Vitoko-Arriagada/Neutrino-2014/README.md

# Neutrino-2014
Neutrino. Robot Autónomo de velocidad

- [Informe][informe]

- [Presentación][presentacion]

Códigos de prueba y para competencia:
- [Neutrino V1.0][ver1]
- [Neutrino V2.0][ver2]
- [Neutrino V3.0][ver3]

  [ver1]: https://github.com/Vitoko-Arriagada/Neutrino-2014/tree/main/Neutrino%20version%201.0
  [ver2]: https://github.com/Vitoko-Arriagada/Neutrino-2014/tree/main/Neutrino%20version%202.0/Codigos
  [ver3]: https://github.com/Vitoko-Arriagada/Neutrino-2014/tree/main/Neutrino%20version%203.0
  [informe]: https://github.com/Vitoko-Arriagada/Neutrino-2014/blob/main/Informe%20Neutrino%202014.pdf
  [presentacion]: https://github.com/Vitoko-Arriagada/Neutrino-2014/blob/main/NEUTRINO.pptx
