Vitoko-Arriagada/Neutrino-2014/portada.png

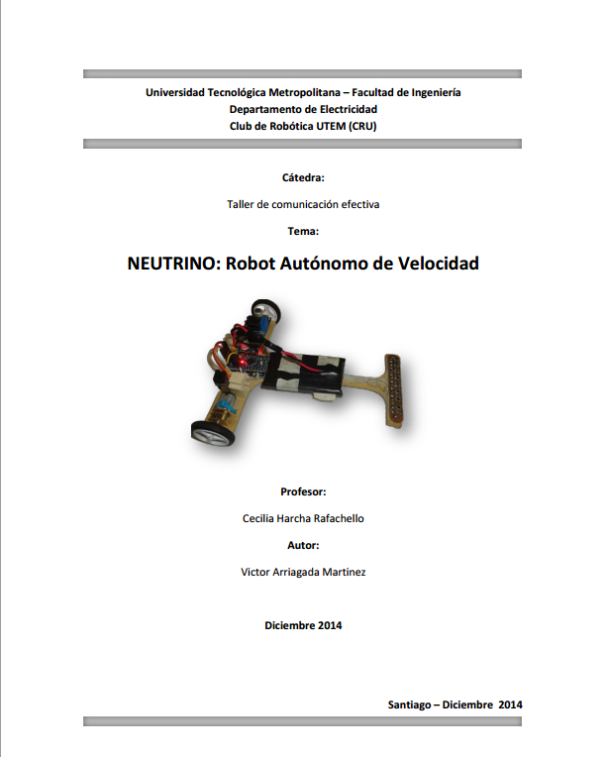
portada.png
