Vitoko-Arriagada/Neutrino-2014/Neutrino version 1.0/PCB Velocidad/PCB.brd

## EAGLE design Neutrino version 1.0/PCB Velocidad/PCB.brd (2022-12-21, an earlier design)

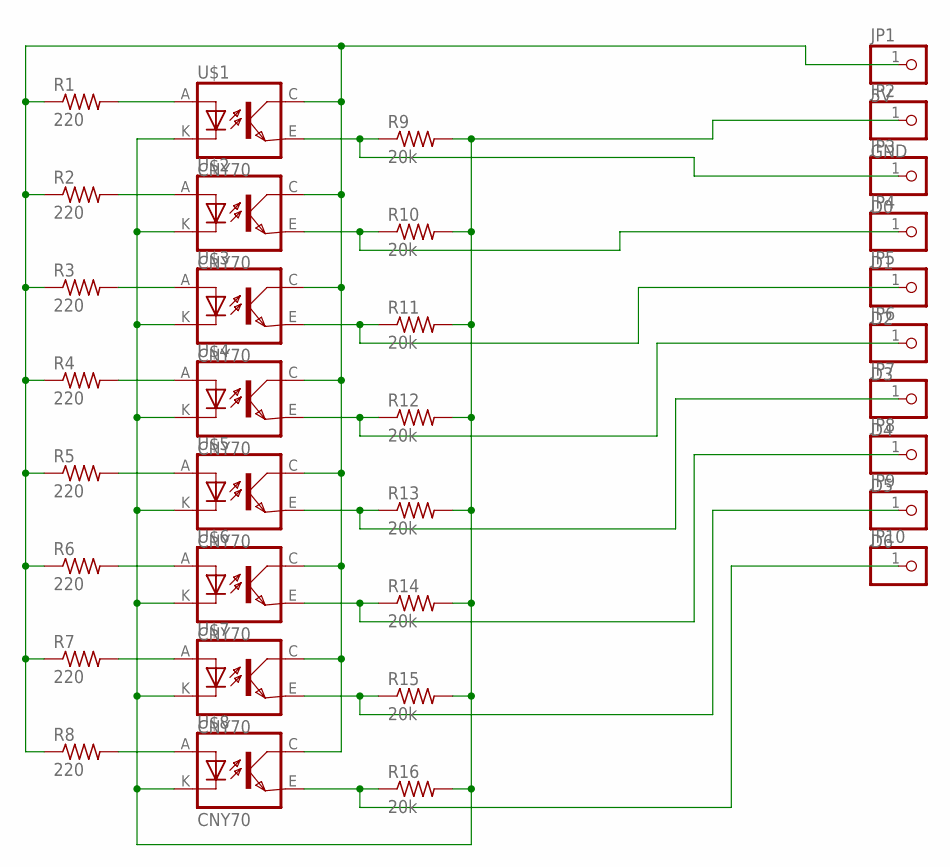
[picture p79: schematic PCB.sch]

Parts:
JP1: 5V; 1X01
JP2: GND; 1X01
JP3: D0; 1X01
JP4: D1; 1X01
JP5: D2; 1X01
JP6: D3; 1X01
JP7: D4; 1X01
JP8: D5; 1X01
JP9: D6; 1X01
JP10: PINHD-1X1; 1X01
R1, R2, R3, R4, R5, R6, R7, R8: 220; R1206
R9, R10, R11, R12, R13, R14, R15, R16: 20k; R1206
U$1, U$2, U$3, U$4, U$5, U$6, U$7, U$8: CNY70; 4

Connections:
unnamed: R1.2, U$1.A
unnamed: R2.2, U$2.A
unnamed: R3.2, U$3.A
unnamed: R4.2, U$4.A
unnamed: R5.2, U$5.A
unnamed: R6.2, U$6.A
unnamed: R7.2, U$7.A
unnamed: R8.2, U$8.A
unnamed: JP10.1, R16.1, U$8.E (EMI)
unnamed: JP9.1, R15.1, U$7.E (EMI)
unnamed: JP8.1, R14.1, U$6.E (EMI)
unnamed: JP7.1, R13.1, U$5.E (EMI)
unnamed: JP6.1, R12.1, U$4.E (EMI)
unnamed: JP5.1, R11.1, U$3.E (EMI)
unnamed: JP4.1, R10.1, U$2.E (EMI)
unnamed: JP3.1, R9.1, U$1.E (EMI)
unnamed: JP1.1, R1.1, R2.1, R3.1, R4.1, R5.1, R6.1, R7.1, R8.1, U$1.C (COL), U$2.C (COL), U$3.C (COL), U$4.C (COL), U$5.C (COL), U$6.C (COL), U$7.C (COL), U$8.C (COL)
unnamed: JP2.1, R9.2, R10.2, R11.2, R12.2, R13.2, R14.2, R15.2, R16.2, U$1.K (C), U$2.K (C), U$3.K (C), U$4.K (C), U$5.K (C), U$6.K (C), U$7.K (C), U$8.K (C)

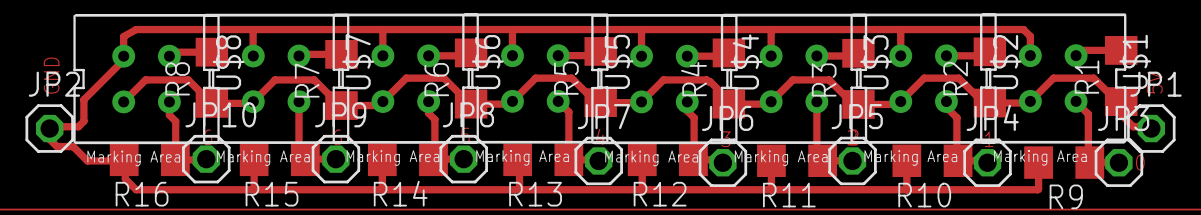
[picture p80: board PCB.brd from above]

Board: 2 copper layers, 34 parts (0 on the bottom side), 18 nets.
