Vitoko-Arriagada/Neutrino-2014/Neutrino version 1.0/PCB Velocidad/Imprimir.brd

## EAGLE design Neutrino version 1.0/PCB Velocidad/Imprimir.brd (2022-12-21, an earlier design)

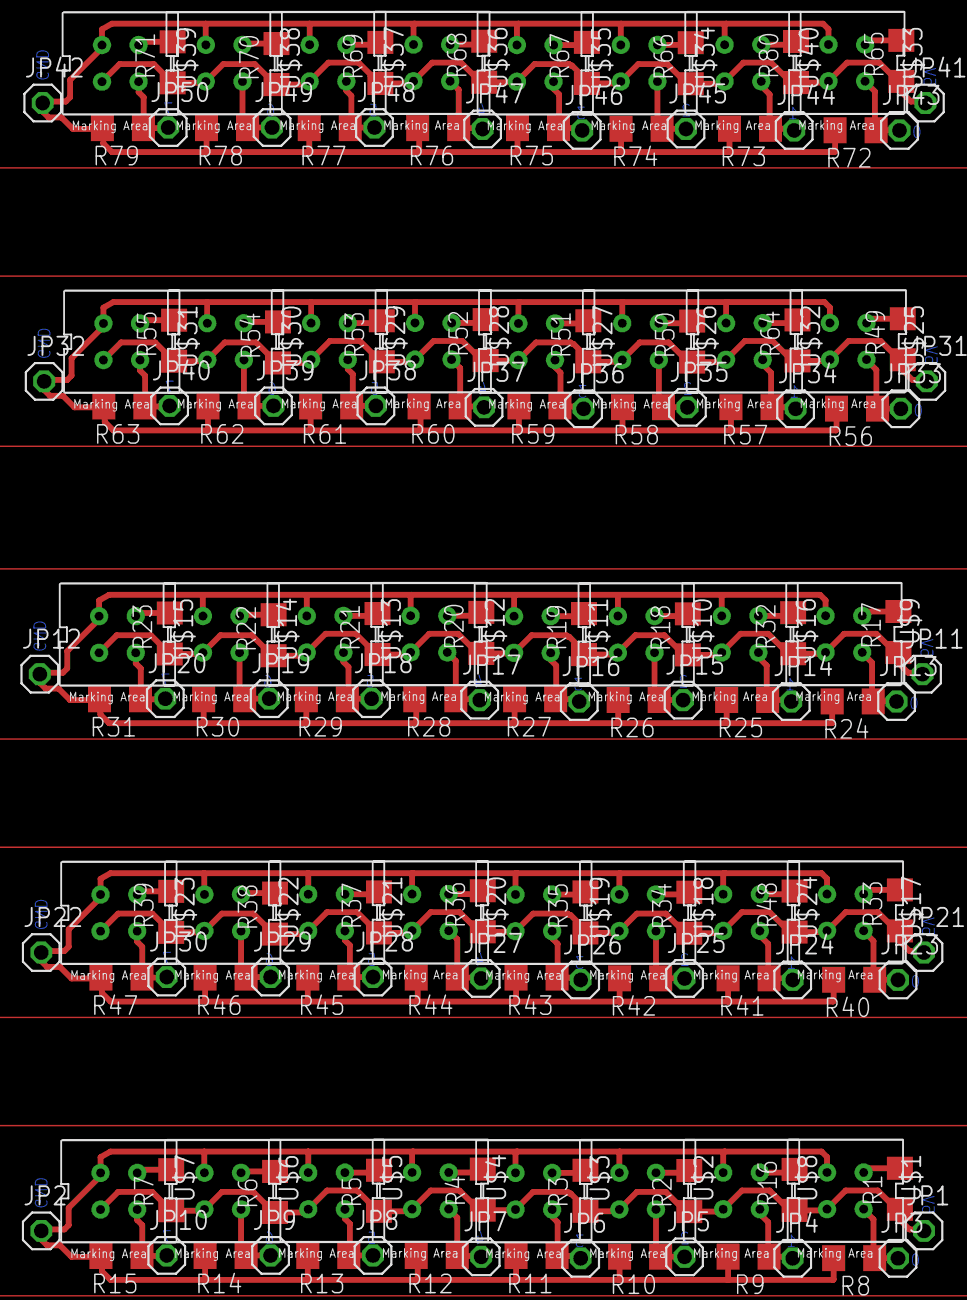
[picture p81: board Imprimir.brd from above]

Board: 2 copper layers, 170 parts (0 on the bottom side), 90 nets.

Parts:
JP1, JP11, JP21, JP31, JP41: 5V; 1X01
JP2, JP12, JP22, JP32, JP42: GND; 1X01
JP3, JP13, JP23, JP33, JP43: D0; 1X01
JP4, JP14, JP24, JP34, JP44: D1; 1X01
JP5, JP15, JP25, JP35, JP45: D2; 1X01
JP6, JP16, JP26, JP36, JP46: D3; 1X01
JP7, JP17, JP27, JP37, JP47: D4; 1X01
JP8, JP18, JP28, JP38, JP48: D5; 1X01
JP9, JP19, JP29, JP39, JP49: D6; 1X01
JP10, JP20, JP30, JP40, JP50: 1X01
R1, R2, R3, R4, R5, R6, R7, R16, R17, R18, R19, R20, R21, R22, R23, R32, R33, R34, R35, R36, R37, R38, R39, R48, R49, R50, R51, R52, R53, R54, R55, R64, R65, R66, R67, R68, R69, R70, R71, R80: 220; R1206
R8, R9, R10, R11, R12, R13, R14, R15, R24, R25, R26, R27, R28, R29, R30, R31, R40, R41, R42, R43, R44, R45, R46, R47, R56, R57, R58, R59, R60, R61, R62, R63, R72, R73, R74, R75, R76, R77, R78, R79: 20k; R1206
U$1, U$2, U$3, U$4, U$5, U$6, U$7, U$8, U$9, U$10, U$11, U$12, U$13, U$14, U$15, U$16, U$17, U$18, U$19, U$20, U$21, U$22, U$23, U$24, U$25, U$26, U$27, U$28, U$29, U$30, U$31, U$32, U$33, U$34, U$35, U$36, U$37, U$38, U$39, U$40: CNY70; 4

Connections:
unnamed: R1.2, U$1.A
unnamed: R2.2, U$2.A
unnamed: R3.2, U$3.A
unnamed: R4.2, U$4.A
unnamed: R5.2, U$5.A
unnamed: R6.2, U$6.A
unnamed: R7.2, U$7.A
unnamed: JP10.1, R15.1, U$7.E
unnamed: JP9.1, R14.1, U$6.E
unnamed: JP8.1, R13.1, U$5.E
unnamed: JP7.1, R12.1, U$4.E
unnamed: JP6.1, R11.1, U$3.E
unnamed: JP5.1, R10.1, U$2.E
unnamed: JP4.1, R9.1, U$8.E
unnamed: JP3.1, R8.1, U$1.E
unnamed: JP1.1, R1.1, R2.1, R3.1, R4.1, R5.1, R6.1, R7.1, R16.1, U$1.C, U$2.C, U$3.C, U$4.C, U$5.C, U$6.C, U$7.C, U$8.C
unnamed: JP2.1, R8.2, R9.2, R10.2, R11.2, R12.2, R13.2, R14.2, R15.2, U$1.K, U$2.K, U$3.K, U$4.K, U$5.K, U$6.K, U$7.K, U$8.K
unnamed: R16.2, U$8.A
unnamed: R17.2, U$9.A
unnamed: R18.2, U$10.A
unnamed: R19.2, U$11.A
unnamed: R20.2, U$12.A
unnamed: R21.2, U$13.A
unnamed: R22.2, U$14.A
unnamed: R23.2, U$15.A
unnamed: JP20.1, R31.1, U$15.E
unnamed: JP19.1, R30.1, U$14.E
unnamed: JP18.1, R29.1, U$13.E
unnamed: JP17.1, R28.1, U$12.E
unnamed: JP16.1, R27.1, U$11.E
unnamed: JP15.1, R26.1, U$10.E
unnamed: JP14.1, R25.1, U$16.E
unnamed: JP13.1, R24.1, U$9.E
unnamed: JP11.1, R17.1, R18.1, R19.1, R20.1, R21.1, R22.1, R23.1, R32.1, U$9.C, U$10.C, U$11.C, U$12.C, U$13.C, U$14.C, U$15.C, U$16.C
unnamed: JP12.1, R24.2, R25.2, R26.2, R27.2, R28.2, R29.2, R30.2, R31.2, U$9.K, U$10.K, U$11.K, U$12.K, U$13.K, U$14.K, U$15.K, U$16.K
unnamed: R32.2, U$16.A
unnamed: R33.2, U$17.A
unnamed: R34.2, U$18.A
unnamed: R35.2, U$19.A
unnamed: R36.2, U$20.A
unnamed: R37.2, U$21.A
unnamed: R38.2, U$22.A
unnamed: R39.2, U$23.A
unnamed: JP30.1, R47.1, U$23.E
unnamed: JP29.1, R46.1, U$22.E
unnamed: JP28.1, R45.1, U$21.E
unnamed: JP27.1, R44.1, U$20.E
unnamed: JP26.1, R43.1, U$19.E
unnamed: JP25.1, R42.1, U$18.E
unnamed: JP24.1, R41.1, U$24.E
unnamed: JP23.1, R40.1, U$17.E
unnamed: JP21.1, R33.1, R34.1, R35.1, R36.1, R37.1, R38.1, R39.1, R48.1, U$17.C, U$18.C, U$19.C, U$20.C, U$21.C, U$22.C, U$23.C, U$24.C
unnamed: JP22.1, R40.2, R41.2, R42.2, R43.2, R44.2, R45.2, R46.2, R47.2, U$17.K, U$18.K, U$19.K, U$20.K, U$21.K, U$22.K, U$23.K, U$24.K
unnamed: R48.2, U$24.A
unnamed: R49.2, U$25.A
unnamed: R50.2, U$26.A
unnamed: R51.2, U$27.A
unnamed: R52.2, U$28.A
unnamed: R53.2, U$29.A
unnamed: R54.2, U$30.A
unnamed: R55.2, U$31.A
unnamed: JP40.1, R63.1, U$31.E
unnamed: JP39.1, R62.1, U$30.E
unnamed: JP38.1, R61.1, U$29.E
unnamed: JP37.1, R60.1, U$28.E
unnamed: JP36.1, R59.1, U$27.E
unnamed: JP35.1, R58.1, U$26.E
unnamed: JP34.1, R57.1, U$32.E
unnamed: JP33.1, R56.1, U$25.E
unnamed: JP31.1, R49.1, R50.1, R51.1, R52.1, R53.1, R54.1, R55.1, R64.1, U$25.C, U$26.C, U$27.C, U$28.C, U$29.C, U$30.C, U$31.C, U$32.C
unnamed: JP32.1, R56.2, R57.2, R58.2, R59.2, R60.2, R61.2, R62.2, R63.2, U$25.K, U$26.K, U$27.K, U$28.K, U$29.K, U$30.K, U$31.K, U$32.K
unnamed: R64.2, U$32.A
unnamed: R65.2, U$33.A
unnamed: R66.2, U$34.A
unnamed: R67.2, U$35.A
unnamed: R68.2, U$36.A
unnamed: R69.2, U$37.A
unnamed: R70.2, U$38.A
unnamed: R71.2, U$39.A
unnamed: JP50.1, R79.1, U$39.E
unnamed: JP49.1, R78.1, U$38.E
unnamed: JP48.1, R77.1, U$37.E
unnamed: JP47.1, R76.1, U$36.E
unnamed: JP46.1, R75.1, U$35.E
unnamed: JP45.1, R74.1, U$34.E
unnamed: JP44.1, R73.1, U$40.E
unnamed: JP43.1, R72.1, U$33.E
unnamed: JP41.1, R65.1, R66.1, R67.1, R68.1, R69.1, R70.1, R71.1, R80.1, U$33.C, U$34.C, U$35.C, U$36.C, U$37.C, U$38.C, U$39.C, U$40.C
unnamed: JP42.1, R72.2, R73.2, R74.2, R75.2, R76.2, R77.2, R78.2, R79.2, U$33.K, U$34.K, U$35.K, U$36.K, U$37.K, U$38.K, U$39.K, U$40.K
unnamed: R80.2, U$40.A
